How2-Oh/weather-box/Pix/Installed.jpg

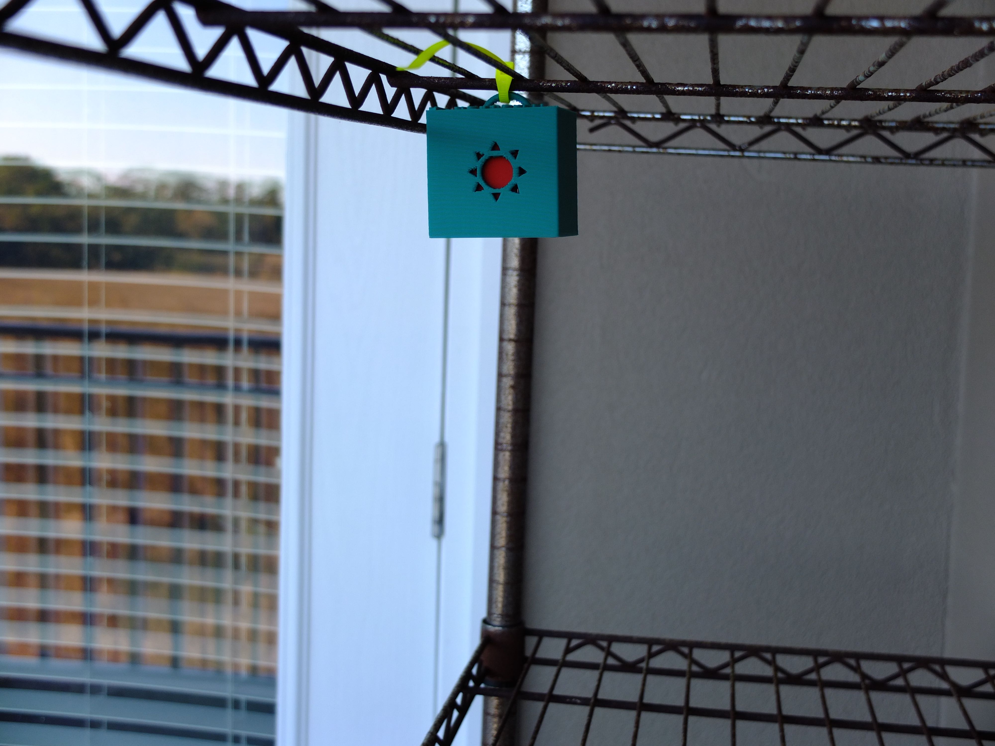
Pix/Installed.jpg
