How2-Oh/weather-box/Pix/STL_Prints.jpg

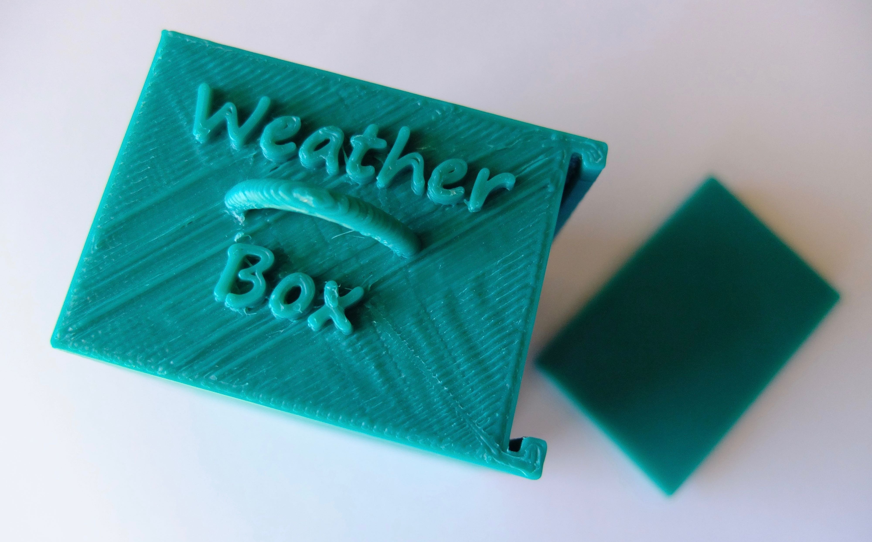
Pix/STL_Prints.jpg
