How2-Oh/weather-box/Pix/Notebook.jpg

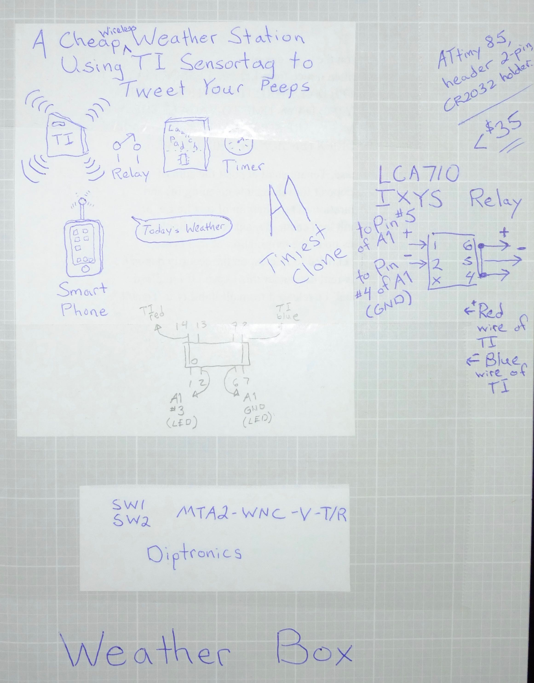
Pix/Notebook.jpg
