How2-Oh/weather-box/Pix/Ready.jpg

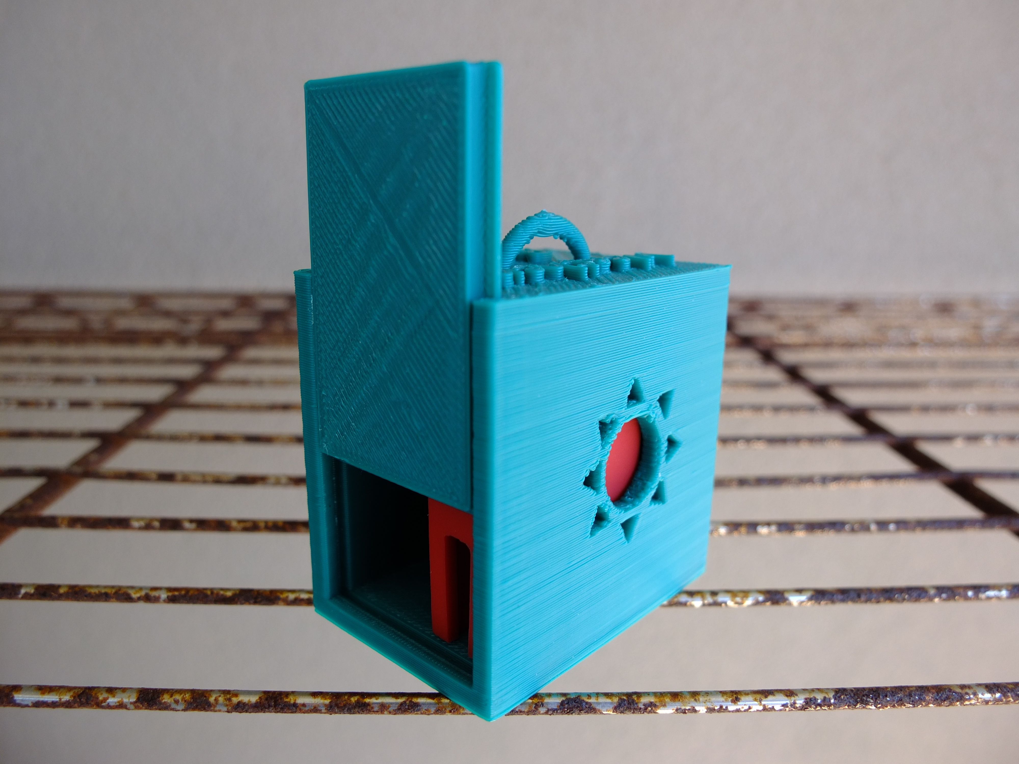
Pix/Ready.jpg
