How2-Oh/weather-box/Pix/Relay.jpg

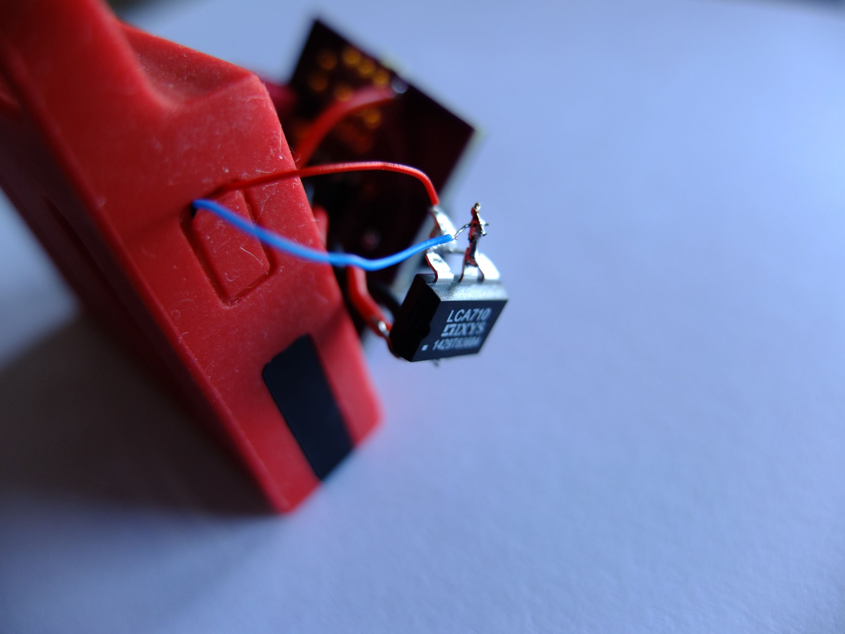
Pix/Relay.jpg
