How2-Oh/weather-box/Pix/SW1.jpg

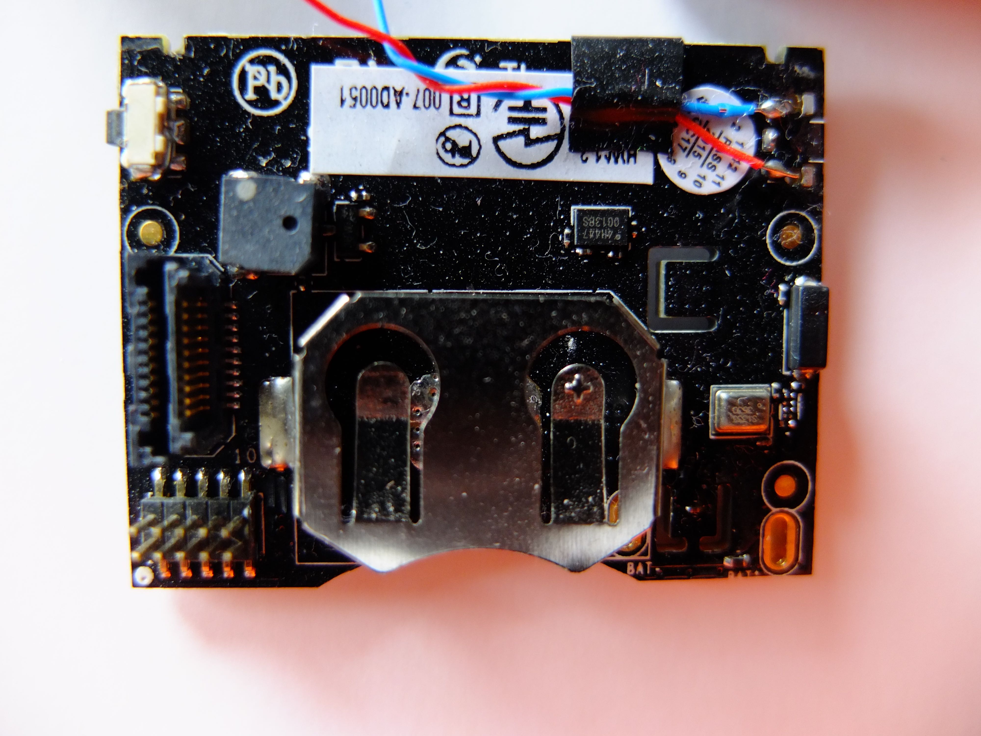
Pix/SW1.jpg
