How2-Oh/weather-box/Pix/SW1_Wires.jpg

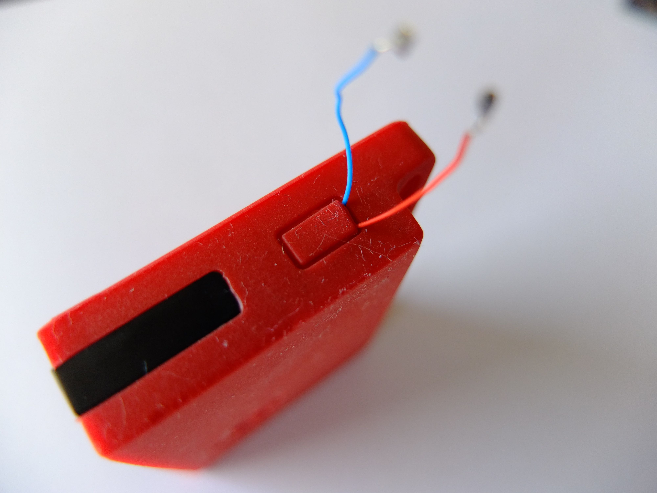
Pix/SW1_Wires.jpg
