How2-Oh/weather-box/(commit log)

2016-01-22 Added Arduino Code
2016-01-22 Update README.md
    Added Thingiverse link for STL files.
